diyaudioby/amp-lm3886-mauro-vidalgo/readme.md

## LM3886 Mauro + Vidalgo

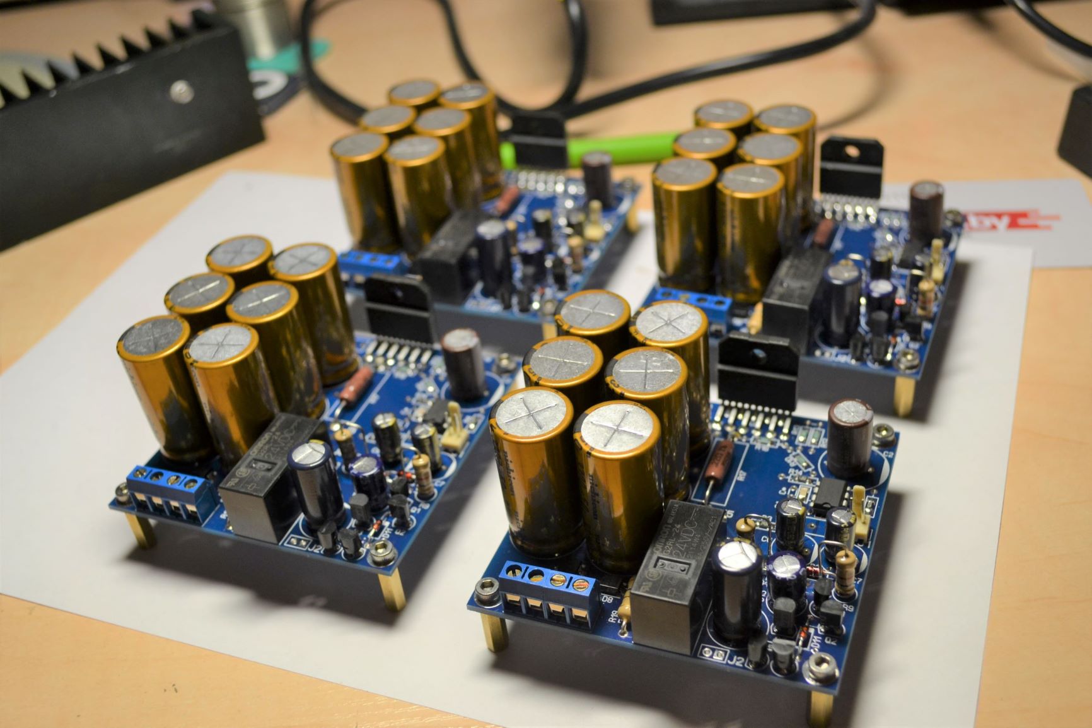
[picture p1: images/0032.JPG]
lm3886-mauro-vidalgo


### Description
Simple audio amplifier based on lm3886 chip.
With power supply and protect circuit on board. 
Good solutions for ative crossovers.

### Links
- [https://diyaudio.by/audio/amplifiers/usilitel-lm3886-mauro-vidalgo/](https://diyaudio.by/audio/amplifiers/usilitel-lm3886-mauro-vidalgo/)

### Authors
- Shematic and PCB design - Vitaly Ovseitsev

### Buy parts for assembling
- [Order PCB from PCBWay](https://www.pcbway.com/project/shareproject/lm3886_mauro_vidalgo.html)

### Folder structure
Most folder names are self explanatory.
- 3d - contains 3d models of PCB
- bom - contains the bill of materials
- docs - contains drawings and images outputs of schematic and PCB files, assembling manuals
- firmware - contains compiled binary files
- gerbers - contains zip file of the PCB Gerbers and drill drawings for manufacture
- images - contain photo of assembling prototype
- pcb - contains the original schematic and PCB design files (Altium Designer,  KiCAD, SprintLayout, etc)
- soft - contains custom software using, for example, for operate with this device 
- source - contains project souce code (sketchs for Arduino, files C/C++, etc)
