diyaudioby/amp-lm3886-mauro-vidalgo/docs/lm3886-mauro-vidalgo-pcb.png

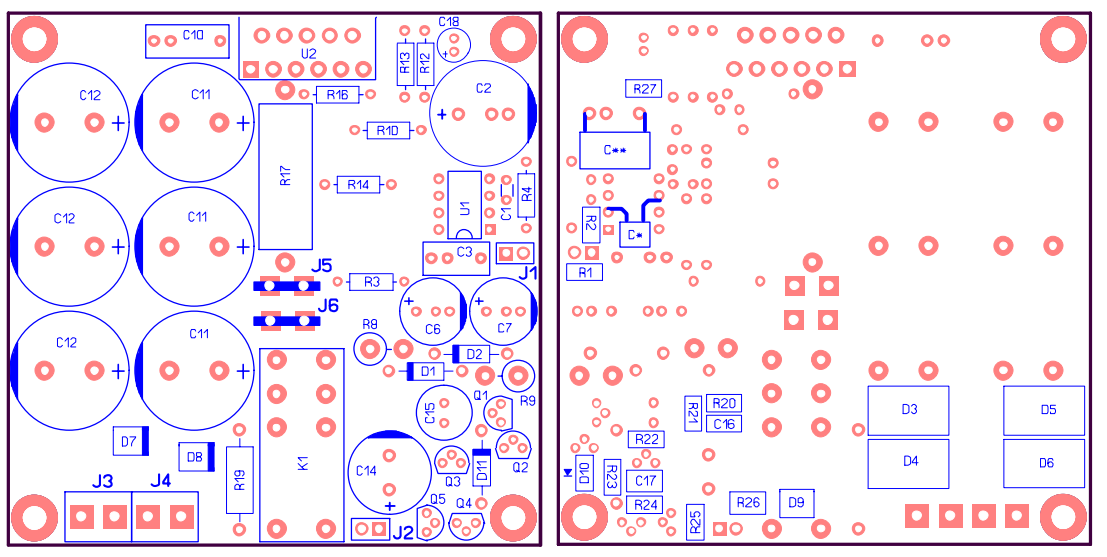
docs/lm3886-mauro-vidalgo-pcb.png
