diyaudioby/amp-lm3886-mauro-vidalgo/docs/lm3886-mauro-vidalgo-sch.png

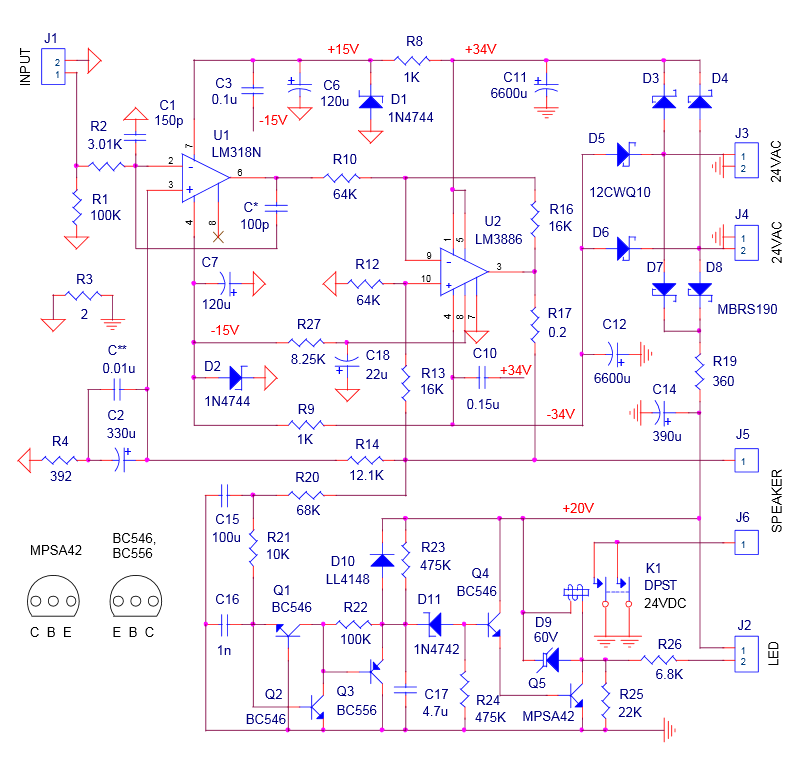
docs/lm3886-mauro-vidalgo-sch.png
