diyaudioby/amp-lm3886-mauro-vidalgo/bom/lm3886-mauro-vidalgo-bom.xlsx

Таблица заказа комплектации lm3886-mauro-vidalgo | ФИО |  |  | Комплектация | 2910
1. Сохранить таблицу (Файл - Скачать - Microsoft Excel) | Адрес доставки |  |  | Доставка
2. Проставить нужное количество деталек (столбец Е) либо удалить | Пункт выдачи заказа CDEK |  |  | Итого | 2910
3. Заполнить контактные данные | Телефон
4. Отправить на diyaudioby@gmail.com | Email
Позиция | Номинал | Доп. инфо | Кол-во | Цена, рос. руб | Сумма
Платы, трансформатор
Платы |  |  | 1 | 100 | 100
Трансформатор | 60Вт, 2 x 22V x 1.3A |  | 1 | 1000 | 1000
Шестигр. стойка для п/плат М3,латунь | PCHSS-10 |  | 4 | 5 | 20
Конденсаторы SMD 1206
C*, C1 | 100pF x 50V | NPO | 2 | 1 | 2
C** | 10nF x 50V | NPO | 1 | 3 | 3
C16 | 10nF x 50V | X7R | 1 | 0.5 | 0.5
C17 | 4.7uF x 16V | 20% Y5V | 1 | 2 | 2
Конденсаторы плёночные выводные
C3 | 0.1uF x 250V 5% | PPM, Kemet, LS = 5mm | 1 | 27 | 27
C10 | 0.22uF x 250V 5% | PPM, Kemet, LS = 10mm | 1 | 42 | 42
Конденсаторы электролитические выводные
C2 | 330uF x 6.3V | Nichicon ES BP (Bi-polar) | 1 | 36 | 36
C6, C7 | 100uF x 25V | Panasonic NGH | 2 | 8 | 16
C11, C12 | 3300uF x 35V | Panasonic FC | 6 | 90 | 540
C14 | 470uF x 35V | Panasonic FC | 1 | 30 | 30
C15 | 100uF x 25V | Panasonic (Bi-polar) | 1 | 25 | 25
C18 | 22uF x 25V | China | 1 | 2 | 2
Резисторы SMD 1206 1% Yageo
R3 | 2R |  | 1 | 0.5 | 0.5
R4 | 402R |  | 1 | 0.5 | 0.5
R2 | 3k |  | 1 | 0.5 | 0.5
R26 | 6.8k |  | 1 | 0.5 | 0.5
R27 | 8.2k |  | 1 | 0.5 | 0.5
R21 | 10k |  | 1 | 0.5 | 0.5
R14 | 12k |  | 1 | 0.5 | 0.5
R25 | 22k |  | 1 | 0.5 | 0.5
R20 | 68k |  | 1 | 0.5 | 0.5
R1, R22 | 100k |  | 2 | 0.5 | 1
R23, R24 | 475k |  | 2 | 0.5 | 1
Резисторы SMD 1206 0.1% Susumi RG
R10, R12 | 40.2k 0.1% |  | 4 | 25 | 100
R13, R16 | 10k 0.1% |  | 4 | 25 | 100
Резисторы выводные 1Вт 5% Yageo
R19 | 360R | MFR100JT-73 | 1 | 4 | 4
R8, R9 | 1k | MFR100JT-73 | 2 | 4 | 8
Резисторы выводные 3Вт 5%
R17 | 0.22R | Vishay Dale | 1 | 75 | 75
Диоды, стабилитроны
D1, D2 | 1N4744 (15V) | DO-41 | 2 | 3 | 6
D3 - D6 | VS50WQ10 | D-PAK | 4 | 42 | 168
D7, D8 | 10MQ100 | SMA | 2 | 6 | 12
D9, D10 | LL4148 | SOD-80 | 2 | 1 | 2
D11 | BZX79-C12 (12V) | DO-35 | 1 | 3 | 3
Транзисторы
Q1, Q2, Q4 | BC546 | TO-92 | 3 | 4 | 12
Q3 | BC556 | TO-92 | 1 | 4 | 4
Q5 | MPSA42 | TO-92 | 1 | 4 | 4
Микросхемы
U1 | LM318N | DIP-8 | 1 | 50 | 50
U2 | LM3886TF | SOT-23 | 1 | 360 | 360
Реле
K1 | G2RL-24-CF-DC24 | Omron | 1 | 120 | 120
Разъёмы
J1 | HU-2F + WF-2M | папа + мама + контакты | 1 | 6 | 6
J3, J4 | DG300-5.0-02P |  | 2 | 7 | 14
J5, J6 | KLS8-01128-PC250 | папа + мама + изолятор | 2 | 5 | 10
