diyaudioby/amp-lm3886-mauro-vidalgo/(list of files, drawings)

Other design files:
pcb/lm3886-mauro-vidalgo-pcb.lay
